milanvidakovic/FPGAComputer/CPU.docx

16-bit CPU

@2018 by Milan Vidaković

# 16-bit CPU

# General information

This 16-bit CPU and computer has been developed using Verilog on the DE0 NANO FPGA board. The code is on the github at the following URL:

https://github.com/milanvidakovic/FPGAComputer

The assembler for this CPU is on the github at the following URL:

https://github.com/milanvidakovic/FPGAcustomasm

The emulator written in Java is on the github at the following URL:

https://github.com/milanvidakovic/FPGAEmulator

The UART loader is on the github at the following URL:

https://github.com/milanvidakovic/FPGARaspbootin64Client

Some photos and background story can be found at:

https://mvidakovic.blogspot.com/2018/06/16-bit-computer-made-using-fpga.html

# Details

This 16-bit CPU has 8 general-purpose registers (r0 – r7), pc (program counter), sp (stack pointer), ir (instruction register), mbr (memory buffer register), h (higher word when multiplying, or remainder when dividing). Each register is 16-bits wide.

The address bus is 16 bits wide, addressing 65536 addresses. Data bus is also 16 bits wide, but all the addresses are 8-bit aligned. This gives 65536 bytes, or 64KB.

By default, address mode is 16-bit. This means that if the instruction does not have the ".b" suffix, it will work with 16-bit operand. Those instructions without ".b" suffix are 16-bit wide. If those instructions deal with memory, the address must be aligned to 16-bits (even).

If the instruction has the ".b" suffix, it is byte-oriented. The address in byte-oriented instructions can be both even and odd.

For example, this instruction is word-oriented:

ld r0, [1000]

It loads the 16-bit content of the address 1000 (two bytes, one byte from the 1001 and the other from 1000) and stores that 16-bit value in the r0 register. The address must be even.

However, this instruction is byte-oriented:

ld.b r0, [1001]

It loads the 8-bit value (one byte) from the address 1001.

It the 16-bit word is stored in the memory, it is stored as big endian, having the lower byte in odd address, and the upper byte in the even address. For example, the number 0x1234 stored at the 1000 address is stored like this:

address | content
1000 | 0x12
1001 | 0x34

Video output signal is VGA, 640x480 pixels. Text mode framebuffer has 80x60 characters, each character being 8x8 pixels in dimensions. Framebuffer in text mode has 4800 16-bit words (80x60 characters with attributes). The lower byte (odd address) has the ASCII character, while the upper byte (even address) has the attributes (3 bits for the ink color, inverted, and 3 bits for the background color, remaining two bits unused).

CPU has three interrupts: IRQ0,IRQ1, and IRQ2. IRQ0 is connected to the KEY2 of the DE0-NANO, while IRQ1 is conencted to the UART. IRQ2 is connected to the PS/2 keyboard connector. Whenever a byte comes to the UART, it generates an IRQ1. Whenever a make or break code comes from the PS/2 keyboard, it generates an IRQ2.

Interrupt causes CPU to push flags to the stack, then to push PC to the stack (the address of the next instruction) and then forces CPU to jump to the location designated for the interrupt:

- for the IRQ0, it is 0x0008,
- for the IRQ1, it is 0x0010, and
- for the IRQ2, it is 0x0018.

It is up to the programmer to put the code in those locations. Usually, it is a JUMP instruction. To return from the interrupt routine, it is necessary to execute the IRET instruction. It pops the return address, and then pops the flags register, and then goes back into the original program.

KEY1 of the DE0-NANO is used as the reset key. When pressed, it forces CPU to go to the 0x0000 address. Usually there is a JUMP instruction to go to the main program.

# VGA text mode

Text mode is 80x60 characters, occupying 4800 words. The framebuffer starts at 26880 decimal. Each character needs two bytes. Lower byte is the ASCII code of a character, while the upper byte is the attributes:

7 | 6 | 5 | 4 | 3 | 2 | 1 | 0
| Foreground color, inverted | | | | Background color
| r | g | b | | r | g | b

The foreground color is inverted so zero values (default) would mean white color. That way, you don't need to set the foreground color to white, and by default (0, 0, 0), is white for the foreground. The default background color is black (0, 0, 0). This means that if the upper (attribute) byte is zero (0x00), the background color is black, and the foreground color is white.

VGA female connector is connected via resistors to the GPIO-0 expansion header of the DE0-NANO board:

- GPIO_R (pin 2, GPIO_00, PIN_A3) -> 68Ohm -> VGA_R,
- GPIO_G (pin 4, GPIO_01, PIN_C3) -> 68Ohm -> VGA_G,
- GPIO_B (pin 6, GPIO_03, PIN_D3) -> 68Ohm -> VGA_B,
- GPIO_HS (pin 8, GPIO_05, PIN_B4) -> 470Ohm -> VGA_HORIZONTAL_SYNC,
- GPIO_VS (pin 10, GPIO_07, PIN_B5) -> 470Ohm -> VGA_VERTICAL_SYNC.

# VGA graphics mode 320x240

This computer also has graphics mode of 320x240 pixels, 8 colors for each pixel. Framebuffer starts at the same address as the text mode one (26880 decimal), but it now displays pixels, instead of characters.

Each pixel can have one of eight colors. There are two pixels per byte in the framebuffer:

7 | 6 | 5 | 4 | 3 | 2 | 1 | 0
| Foreground color, inverted | | | | Background color
| r | g | b | | r | g | b

For example, if you want to draw two red pixels at the (0, 0) coordinates (top left corner), you need to put the following byte into the location 2400:

7 | 6 | 5 | 4 | 3 | 2 | 1 | 0
| Foreground color, inverted | | | | Background color
0 | 1 | 0 | 0 | 0 | 1 | 0 | 0

Or, 0x44 in hex.

Since the default mode is text mode, there is a way to switch video modes:

mov r1, 1

out [128], r1

This code will switch to the graphics mode of 320x240. To switch back to the text mode, you need to execute the following code:

mov r1, 0

out [128], r1

Number 1 at the port 128 sets the video mode to 320x240, while 0 sets to the text mode.

# UART interface

UART interface provides TTL serial communication on 115200kbps. It uses one start bit, one stop bit, and eight data bits, no parity, no handshake.

UART is connected to the GPIO-0 expansion header of the DE0-NANO board:

- TX (pin 32, GPIO_025, PIN_D9) should be connected to the RX pin of the PC,
- RX (pin 34, GPIO_027, PIN_E10) should be connected to the TX pin of the PC.

UART is used within the CPU via IN, and OUT instructions. RX also triggers the IRQ1, which means that whenever a byte is received via UART, the IRQ1 will be triggered, forcing CPU to jump to the 0x0008 address. There you should place the JUMP instruction to your UART interrupt routine.

Inside the UART interrupt routine, you can get the received byte by using the IN instruction:

in r1, [64] ; r1 holds now received byte from the UART (address 64 decimal)

To send a byte, first you need to check if the UART TX is free. You can do it by using the in instruction:

loop:

in r5, [65] ; tx busy in r5

cmp r5, 0

jz not_busy ; if not busy, send back the received character

j loop

not_busy:

out [66], r1 ; send the received character to the UART

Addresses used by the UART are in the following table:

Address | Description
64 | Received byte from the RX part of the UART.
65 | 0 if the TX part of the UART is free to send a byte, 1 if TX part is busy.
66 | Used to put the byte to be sent via TX part of the UART.

# PS/2 keyboard interface

PS/2 connector is connected to the GPIO ports of the DE0-NANO board:

- Data is connected to the GPIO31 (PIN_D11) port
- Clock is connected to the GPIO33 (PIN_B12) port.

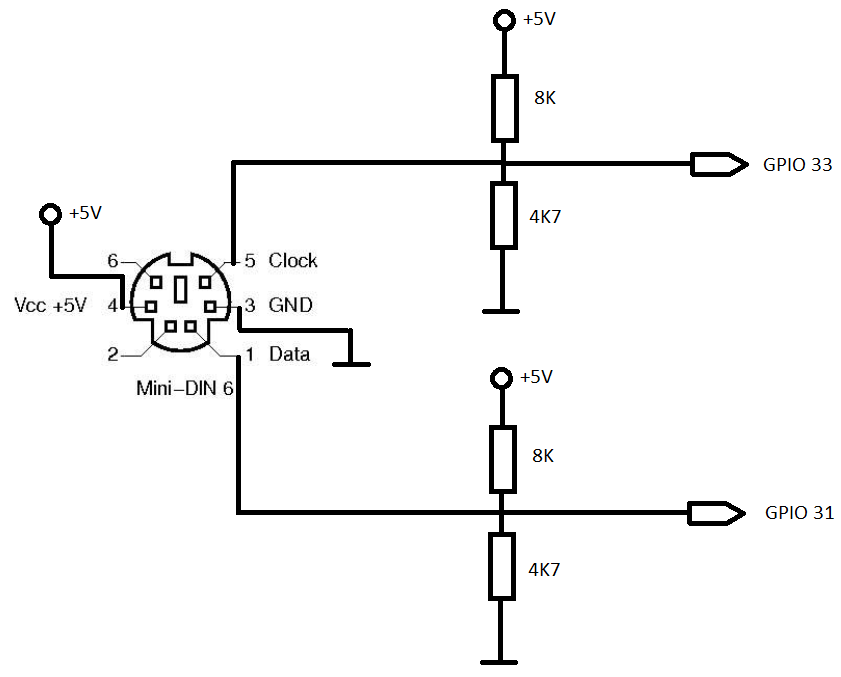
[picture p1: figure]

Connection of the female PS/2 conenctor to the GPIO ports of the DE0 NANO board

The communication between keyboard and computer is a clocked serial. Clock pulses appear on the Clock pin, while data is on the Data pin, synchronized with the Clock on the falling edge. There is one start bit, one parity bit and one stop bit.

The IRQ2 is triggered when a byte from PS/2 keyboard arrives. The CPU then jumps to the address of 24 decimal, where the raw PS/2 keyboard handling routine should be. Actually, at that address should be one JUMP instruction which will jump to the handling routine.

In the interrupt routine, it is necessary to read the raw PS/2 byte that has arrived from the keyboard. To do so, it is necessary to use the IN assembler instruction:

in r0, [68]

Please pay attention that raw PS/2 protocol gives make and break codes when a key is pressed, so this requires quite a lot of processing.

# Instruction set

Group number | Group name | Group members | Group description
0 | NOP/MOV/ IN/OUT/PUSH/ POP/RET/IRET/SWAP/HALT | nop mov reg, xx mov reg, reg in reg, [xx] out [xx], reg push reg push xx pop reg ret iret swap halt | The most general group. Deals with putting values into registers, exchanging values between registers, I/O operations, stack operations, and returning from subroutines. Swapping content between registers is done using th SWAP instruction. NOP and HALT are also in this group.
1 | JUMP | jmp xx jc xx jnc xx jz xx jnz xx jo xx jno xx jp (jge) xx jnp (js) xx jg xx jse xx | Jump to the given location.
2 | CALL | call xx callc xx callnc xx callz xx callnz xx callo xx callno xx callp (callge) xx callnp (calls) xx callg xx callse xx | Calling subroutine. Puts the return address on the stack before jumping to the subroutine. Needs to call RET when returning from the subroutine.
3 | LOAD/STORE | ld reg, [xx] ld reg, [reg] ld reg, [reg + xx] ld.b reg, [reg] ld.b reg, [xx] ld.b reg, [reg + xx] st [xx], reg st [reg], reg st [reg + xx], reg st.b [reg], reg st.b [xx], reg st.b [reg + xx], reg | Load from memory into the register destination: register source: memory address given by the number, or by the register, or by the register+number. Store the given register into the memory location destination: memory location given by the number, or by the register, or by the register+number.
4 | ADD/SUB | add reg, reg add reg, xx add reg, [reg] add reg, [xx] add reg, [reg + xx] add.b reg, [reg] add.b reg, [xx] add.b reg, [reg + xx] sub reg, reg sub reg, xx sub reg, [reg] sub reg, [xx] sub reg, [reg + xx] sub.b reg, [reg] sub.b reg, [xx] sub.b reg, [reg + xx] | ADD and SUB group.
5 | AND/OR | and reg, reg and reg, xx and reg, [reg] and reg, [xx] and reg, [reg + xx] and.b reg, [reg] and.b reg, [xx] and.b reg, [reg + xx] or reg, reg or reg, xx or reg, [reg] or reg, [xx] or reg, [reg + xx] or.b reg, [reg] or.b reg, [xx] or.b reg, [reg + xx] | AND and OR group.
6 | XOR | xor reg, reg xor reg, xx xor reg, [reg] xor reg, [xx] xor reg, [reg + xx] xor.b reg, [reg] xor.b reg, [xx] xor.b reg, [reg + xx] neg reg neg [reg] neg [xx] neg [reg + xx] neg.b [reg] neg.b [xx] neg.b [reg + xx] | XOR and negation (-value).
7 | SHL/SHR | shl reg, reg shl reg, xx shl reg, [reg] shl reg, [xx] shl reg, [reg + xx] shl.b reg, [reg] shl.b reg, [xx] shl.b reg, [reg + xx] shr reg, reg shr reg, xx shr reg, [reg] shr reg, [xx] shr reg, [reg + xx] shr.b reg, [reg] shr.b reg, [xx] shr.b reg, [reg + xx] | Shift left and right.
8 | MUL/DIV | mul reg, reg mul reg, xx mul reg, [reg] mul reg, [xx] mul reg, [reg + xx] mul.b reg, [reg] mul.b reg, [xx] mul.b reg, [reg + xx] div reg, reg div reg, xx div reg, [reg] div reg, [xx] div reg, [reg + xx] div.b reg, [reg] div.b reg, [xx] div.b reg, [reg + xx] | Multiplication and division.
9 | INC/DEC | inc reg inc [reg] inc [xx] inc [reg + xx] inc.b [reg] inc.b [xx] inc.b [reg + xx] dec reg dec [reg] dec [xx] dec [reg + xx] dec.b [reg] dec.b [xx] dec.b [reg + xx] | Increment and decrement.
10 | CMP/INV | cmp reg, reg cmp reg, xx cmp reg, [reg] cmp reg, [xx] cmp reg, [reg + xx] cmp.b reg, [reg] cmp.b reg, [xx] cmp.b reg, [reg + xx] inv reg inv [reg] inv [xx] inv [reg + xx] inv.b [reg] inv.b [xx] inv.b [reg + xx] | Compare registers with registers/memory. Inversion of bits.

# NOP/MOV/IN/OUT/PUSH/POP/RET/IRET/SWAP/HALT GROUP (0x00)

## nop

from | to | what | group
0000 | 0000 | 0000 | 0000

Example:

nop

binary: 0000 0000 0000 0000

hex: 00 00

## mov regx, regy

regx <-- regy

from | to | what | group
bbbb 0-7: r0-r7 8-sp 9-h | bbbb 0-7: r0-r7 8-sp 9-h | 0001 0=>mov regx, regy | 0000

### Example:

mov r2, r1

binary: 0001 0010 0001 0000

hex: 12 00

## mov reg, XX

reg <-- XX

from | to | what | group
xxxx | bbbb 0-7: r0-r7 8-sp | 0010 2 =>mov reg, xx | 0000

### Example:

mov r1, 0x0f

binary: 0000 0001 0010 0000, 0000 0000 0000 1111

hex: 01 20, 00 0f

## in reg, [XX]

from | to | what | group
xxxx | xbbb 0-7: r0-r7 | 0011 3 =>in reg, [xx] | 0000

### Example:

in r1, [0x0f]

binary: 0000 0001 0010 0001, 0000 0000 0000 1111

hex: 01 30, 00 0f

## out [XX], reg

from | to | what | group
xxxx | xbbb 0-7: r0-r7 | 0100 4 =>out [xx], reg | 0000

### Example:

out r1, 0x0f

binary: 0000 0001 0100 0000, 0000 0000 0000 1111

hex: 01 40, 00 0f

## push reg

from | to | what | group
xxxx | bbbb 0-7: r0-r7 8-sp 9-h | 0101 5=>push register | 0000

### Example:

push r0

binary: 0000 0000 0101 0000

hex: 00 50

## push XX

from | to | what | group
xxxx | xxxx | 0110 6=>push number | 0000

### Example:

push 0x0f

binary: 0000 0000 0110 000, 0000 0000 0000 1111

hex: 00 60, 00 0f

## pop reg

from | to | what | group
xxxx | bbbb 0-7: r0-r7 8-sp 9-h | 0111 7=>pop register | 0000

### Example:

pop r0

binary: 0000 0000 0111 0000

hex: 00 70

## ret

Returns from the subroutine.

unused | call/ret kind | group
xxxx xxxx | 1000 8=>return | 0000

### Example:

ret

binary: 0000 0000 1000 0000

hex: 00 80

## iret

Returns from the interrupt subroutine. First it pops flags from the stack, then it pops the return address from the stack.

unused | call/ret kind | group
xxxx xxxx | 10001 9=>return from interrupt | 0000

### Example:

iret

binary: 0000 0000 1001 0000

hex: 00 90

## swap

Swaps two registers content.

from | to | what | group
bbbb 0-7: r0-r7 8-sp 9-h | bbbb 0-7: r0-r7 8-sp 9-h | 1010 10=>swap regx, regy | 0000

### Example:

swap r0, r1

binary: 0000 0001 1010 0000

hex: 00 90

## halt

from | to | what | group
1111 | 1111 | 1111 | 0000

Example:

halt

binary: 1111 1111 1111 0000

hex: ff f0

# JUMP GROUP (0x01)

Jumps (branches).

## jmp xx

Jumps to the given location.

unused | jump kind | group
xxxx xxxx | 0000 jump without condition | 0001

### Example:

j 0xff

binary: 0000 0000 0000 0001, 0000 0000 1111 1111

hex: 00 01, 00 ff

## jz xx

Jumps to the given location, if Zero flag is 1.

unused | jump kind | group
xxxx xxxx | 0001 jump if zero | 0001

### Example:

jz 0001

binary: 0000 0000 0001 0001, 0000 0000 0000 0001

hex: 00 11, 00 01

## jnz xx

Jumps to the given location, if Zero flag is 0.

unused | jump kind | group
xxxx xxxx | 0010 jump if not carry | 0001

### Example:

jnz 0001

binary: 0000 0000 0010 0001, 0000 0000 0000 0001

hex: 00 21, 00 01

## jc xx

Jumps to the given location, if Carry flag is 1.

unused | jump kind | group
xxxx xxxx | 0011 jump if Carry | 0001

### Example:

jc 0001

binary: 0000 0000 0011 0001, 0000 0000 0000 0001

hex: 00 31, 00 01

## jnc xx

Jumps to the given location, if Carry flag is 0.

unused | jump kind | group
xxxx xxxx | 0100 jump if not carry | 0001

### Example:

jnc 0001

binary: 0000 0000 0100 0001, 0000 0000 0000 0001

hex: 00 41, 00 01

## jo xx

Jumps to the given location, if Overflow flag is 1.

unused | jump kind | group
xxxx xxxx | 0101 jump if overflow | 0001

### Example:

jo 0001

binary: 0000 0000 0101 0001, 0000 0000 0000 0001

hex: 00 51, 00 01

## jno xx

Jumps to the given location, if Overflow flag is 0.

unused | jump kind | group
xxxx xxxx | 0110 jump if not overflow | 0001

### Example:

jno 0001

binary: 0000 0000 0110 0001, 0000 0000 0000 0001

hex: 00 61, 00 01

## jp xx (jge xx)

Jumps to the given location, if Positive flag is 1. This is the same as jge xx (jump greater or equal).

unused | jump kind | group
xxxx xxxx | 0111 jump if positive | 0001

### Example:

jp 0001

binary: 0000 0000 0111 0001, 0000 0000 0000 0001

hex: 00 71, 00 01

## jnp xx (js xx)

Jumps to the given location, if Positive flag is 0. The same as js xx (jump if smaller).

unused | jump kind | group
xxxx xxxx | 1000 jump if not positive | 0001

### Example:

jnp 0001

binary: 0000 0000 1000 0001, 0000 0000 0000 0001

hex: 00 81, 00 01

## jg xx

Jumps to the given location, if the last operation produced greater condition (Positive == 1 && Zero == 0).

unused | jump kind | group
xxxx xxxx | 1001 jump if greater | 0001

### Example:

jg 0001

binary: 0000 0000 1001 0001, 0000 0000 0000 0001

hex: 00 91, 00 01

## jse xx

Jumps to the given location, if the last operation produced smaller or equal condition (Positive == 0 && Zero == 1).

unused | jump kind | group
xxxx xxxx | 1010 jump if greater | 0001

### Example:

jse 0001

binary: 0000 0000 1010 0001, 0000 0000 0000 0001

hex: 00 91, 00 01

# CALL GROUP (0x02)

## call xx

Calls the given subroutine.

unused | call/ret kind | group
xxxx xxxx | 0000 call without condition | 0010

### Example:

call 0001

binary: 0000 0000 0000 0010, 0000 0000 0000 0001

hex: 00 02, 00 01

## callz xx

Calls the given location, if Zero flag is 1.

unused | jump kind | group
xxxx xxxx | 0001 call if zero | 0010

### Example:

callz 0001

binary: 0000 0000 0001 0010, 0000 0000 0000 0001

hex: 00 11, 00 01

## callnz xx

Calls the given location, if Zero flag is 0.

unused | jump kind | group
xxxx xxxx | 0010 call if not zero | 0010

### Example:

callnz 0001

binary: 0000 0000 0010 0010, 0000 0000 0000 0001

hex: 00 22, 00 01

## callc xx

Calls the given location, if Carry flag is 1.

unused | jump kind | group
xxxx xxxx | 0011 call if carry | 0010

### Example:

callc 0001

binary: 0000 0000 0011 0010, 0000 0000 0000 0001

hex: 00 32, 00 01

## callnc xx

Calls the given location, if Carry flag is 0.

unused | jump kind | group
xxxx xxxx | 0100 call if not carry | 0010

### Example:

callnc 0001

binary: 0000 0000 0100 0010, 0000 0000 0000 0001

hex: 00 42, 00 01

## callo xx

Calls the given location, if Overflow flag is 1.

unused | jump kind | group
xxxx xxxx | 0101 call if overflow | 0010

### Example:

callo 0001

binary: 0000 0000 0101 0010, 0000 0000 0000 0001

hex: 00 52, 00 01

## callno xx

Calls the given location, if Overflow flag is 0.

unused | jump kind | group
xxxx xxxx | 0110 call if not overflow | 0010

### Example:

callno 0001

binary: 0000 0000 0110 0010, 0000 0000 0000 0001

hex: 00 62, 00 01

## callp xx (callge xx)

Calls the given location, if Positive flag is 1. This is the same as callge xx (call if greater or equal).

unused | jump kind | group
xxxx xxxx | 0001 call if positive | 0010

### Example:

callp 0001

binary: 0000 0000 0111 0010, 0000 0000 0000 0001

hex: 00 72, 00 01

## callnp xx (calls xx)

Calls the given location, if Positive flag is 0. This is the same as calls xx (call if smaller).

unused | jump kind | group
xxxx xxxx | 1000 jump if not positive | 0010

### Example:

callnp 0001

binary: 0000 0000 1000 0010, 0000 0000 0000 0001

hex: 00 82, 00 01

## callg xx

Calls the given location, if the last operation produced greater condition (Positive == 1 && Zero == 0).

unused | jump kind | group
xxxx xxxx | 1001 call if greater | 0010

### Example:

callg 0001

binary: 0000 0000 1001 0010, 0000 0000 0000 0001

hex: 00 92, 00 01

## callse xx

Calls the given location, if the last operation produced smaller or equal condition (Positive == 0 && Zero == 1).

unused | jump kind | group
xxxx xxxx | 1010 call if smaller or equal | 0010

### Example:

callse 0001

binary: 0000 0000 1010 0010, 0000 0000 0000 0001

hex: 00 a2, 00 01

# LOAD/STORE GROUP (0x03)

## ld regx, [regy]

Loads one word (two bytes) from the location to which regy points.

from | to | what | group
bbbb 0-7: r0-r7 8: sp 9: h | bbbb 0-7: r0-r7 8: sp 9: h | 0000 0=>[register] | 0011

### Example:

ld r2, [r1]

binary: 0001 0010 0000 0011

hex: 12 03

## ld reg, [XX]

from | to | what | group
xxx | bbbb 0-7: r0-r7 8: sp 9: h | 0001 1=>[number] | 0011

### Example:

ld r1, [0x0f]

binary: 0000 0001 0001 0011, 0000 0000 0000 1111

hex: 01 13, 00 0f

## ld regx, [regy + XX]

from | to | what | group
bbbb 0-7: r0-r7 8: sp 9: h | bbbb 0-7: r0-r7 8: sp 9: h | 0010 2=>[reg+number] | 0011

### Example:

ld r4, [r3 + 0x0f]

binary: 0011 0100 0010 0011, 0000 0000 0000 1111

hex: 34 23, 00 0f

## ld.b regx, [regy]

Loads one byte from the address to which regy points

from | to | what | group
bbbb 0-7: r0-r7 8: sp 9: h | bbbb 0-7: r0-r7 8: sp 9: h | 0011 3=>[register] | 0011

### Example:

ld.b r2, [r1]

binary: 0001 0010 0011 0011

hex: 12 33

## ld.b reg, [XX]

Loads one byte from the address to which a given number points.

from | to | what | group
xxx | bbbb 0-7: r0-r7 8: sp 9: h | 0100 4=>[number] | 0011

### Example:

ld.b r1, [0x0f]

binary: 0000 0001 0100 0011, 0000 0000 0000 1111

hex: 01 43, 00 0f

## ld.b reg, [reg + XX]

Loads one byte from the address to which a sum of a given register plus given number points.

from | to | what | group
bbbb 0-7: r0-r7 8: sp 9: h | bbbb 0-7: r0-r7 8: sp 9: h | 0101 5=>[reg+number] | 0011

### Example:

ld.b r4, [r3 + 0x0f]

binary: 0011 0100 0101 0011, 0000 0000 0000 1111

hex: 34 53, 00 0f

## st [regy], regx

Stores a regx to the location to which regy points.

from | to | what | group
bbbb 0-7: r0-r7 8: sp 9: h | bbbb 0-7: r0-r7 8: sp 9: h | 1000 8=>register | 0011

### Example:

st [r1], r2

binary: 0010 0001 1001 0011

hex: 21 83

## st [XX], reg

from | to | what | group
bbbb 0-7: r0-r7 8: sp 9: h | xxxx | 1009 9=>number | 0011

### Example:

st [0x0f], r1

binary: 0001 0000 1001 0011, 0000 0000 0000 1111

hex: 10 93, 00 0f

## st [reg + XX], reg

from | to | what | group
bbbb 0-7: r0-r7 8: sp 9: h | bbbb 0-7: r0-r7 8: sp 9: h | 1010 10=>reg+number | 0011

### Example:

st [r3 + 0x0f], r4

binary: 0100 0011 1010 0011, 0000 0000 0000 1111

hex: 43 a3, 00 0f

## st.b [regy], regx

Stores a byte from regx to the location to which regx points.

from | to | what | group
bbbb 0-7: r0-r7 8: sp 9: h | bbbb 0-7: r0-r7 8: sp 9: h | 1011 11=>register | 0011

### Example:

st.b [r1], r2

binary: 0010 0001 1011 0011

hex: 21 b3

## st.b [XX], reg

Stores a byte from reg to the location to which a given number points.

from | to | what | group
bbbb 0-7: r0-r7 8: sp 9: h | xxxx | 1100 12=>number | 0011

### Example:

st.b [0x0f], r1

binary: 0001 0000 1100 0011, 0000 0000 0000 1111

hex: 10 c3, 00 0f

## st.b [regy + XX], regx

Stores a byte from regx to the location to which sum of regx plus a given number points.

from | to | what | group
bbbb 0-7: r0-r7 8: sp 9: h | bbbb 0-7: r0-r7 8: sp 9: h | 1101 13=>reg+number | 0011

### Example:

st.b [r3 + 0x0f], r4

binary: 0100 0011 1101 0011, 0000 0000 0000 1111

hex: 43 d3, 00 0f

# ADD/SUB GROUP (0x0004)

## add regx, regy

regx = regx + regy

from | to | what | group
bbbb 0-7: r0-r7 8: sp 9: h | bbbb 0-7: r0-r7 8: sp 9: h | 0000 0=>regx = regx + regy | 0100

### Example:

add r0, r1

binary: 0001 0000 0000 0100

hex: 10 04

## add reg, xx

regx = regx + xx

from | to | what | group
xxxxx | bbbb 0-7: r0-r7 8: sp 9: h | 0001 1=>regx = regx + xx | 0100

### Example:

add r0, 2

binary: 0000 0000 0001 0100, 0000 0000 0000 0010

hex: 00 14, 00 02

## add regx, [regy]

regx = regx + memory_content(regy)

from | to | what | group
bbbb 0-7: r0-r7 8: sp 9: h | bbbb 0-7: r0-r7 8: sp 9: h | 0010 2=>regx = regx + memory_content(regy) | 0100

### Example:

add r0, [r1]

binary: 0001 0000 0010 0100

hex: 10 24

## add reg, [xx]

regx = regx + memory_content(xx)

from | to | what | group
xxxxx | bbbb 0-7: r0-r7 8: sp 9: h | 0011 3=>regx = regx + memory_content(xx) | 0100

### Example:

add r0, [2]

binary: 0000 0000 0011 0100, 0000 0000 0000 0010

hex: 00 34, 00 02

## add regx, [regy + xx]

regx = regx + memory_content(regy + xx)

from | to | what | group
bbbb 0-7: r0-r7 8: sp 9: h | bbbb 0-7: r0-r7 8: sp 9: h | 0100 4=>regx = regx + memory_content(regy + xx) | 0100

### Example:

add r0, [r1 + 5]

binary: 0001 0000 0100 0100, 0000 0000 0000 0101

hex: 10 44, 00 02

## add.b regx, [regy]

regx = regx + byte_memory_content(regy)

from | to | what | group
bbbb 0-7: r0-r7 8: sp 9: h | bbbb 0-7: r0-r7 8: sp 9: h | 0101 5=>regx = regx + byte_memory_content(regy) | 0100

### Example:

add.b r0, [r1]

binary: 0001 0000 0101 0100

hex: 10 54

## add.b reg, [xx]

regx = regx + byte_memory_content(xx)

from | to | what | group
xxxxx | bbbb 0-7: r0-r7 8: sp 9: h | 0110 6=>regx = regx + byte_memory_content(xx) | 0100

### Example:

add.b r0, [2]

binary: 0000 0000 0110 0100, 0000 0000 0000 0010

hex: 00 64, 00 02

## add.b regx, [regy + xx]

regx = regx + byte_memory_content(regy + xx)

from | to | what | group
bbbb 0-7: r0-r7 8: sp 9: h | bbbb 0-7: r0-r7 8: sp 9: h | 0111 7=>regx = regx + byte_memory_content(regy + xx) | 0100

### Example:

add.b r0, [r1 + 5]

binary: 0001 0000 0100 0100, 0000 0000 0000 0101

hex: 10 74, 00 02

## sub regx, regy

regx = regx - regy

from | to | what | group
bbbb 0-7: r0-r7 8: sp 9: h | bbbb 0-7: r0-r7 8: sp 9: h | 1000 8=>regx = regx - regy | 0100

### Example:

sub r0, r1

binary: 0100 0000 1000 0100

hex: 40 84

## sub reg, xx

regx = regx + xx

from | to | what | group
xxxx | bbbb 0-7: r0-r7 8: sp 9: h | 1001 9=>regx = regx + xx | 0100

### Example:

sub r0, 2

binary: 0000 0000 1001 0100, 0000 0000 0000 0010

hex: 00 94, 00 02

## sub regx, [regy]

regx = regx - memory_content(regy)

from | to | what | group
bbbb 0-7: r0-r7 8: sp 9: h | bbbb 0-7: r0-r7 8: sp 9: h | 1010 10=>regx = regx - memory_content(regy) | 0100

### Example:

sub r0, [r1]

binary: 0001 0000 1010 0100

hex: 10 a4

## sub reg, [xx]

regx = regx - memory_content(xx)

from | to | what | group
xxxxx | bbbb 0-7: r0-r7 8: sp 9: h | 1011 11=>regx = regx - memory_content(xx) | 0100

### Example:

sub r0, [2]

binary: 0000 0000 1011 0100, 0000 0000 0000 0010

hex: 00 b4, 00 02

## sub regx, [regy + xx]

regx = regx - memory_content(regy + xx)

from | to | what | group
bbbb 0-7: r0-r7 8: sp 9: h | bbbb 0-7: r0-r7 8: sp 9: h | 1100 12=>regx = regx - memory_content(regy + xx) | 0100

### Example:

sub r0, [r1 + 5]

binary: 0001 0000 1100 0100, 0000 0000 0000 0101

hex: 10 c4, 00 05

## sub.b regx, [regy]

regx = regx - byte_memory_content(regy)

from | to | what | group
bbbb 0-7: r0-r7 8: sp 9: h | bbbb 0-7: r0-r7 8: sp 9: h | 1101 13=>regx = regx – byte_memory_content(regy) | 0100

### Example:

sub.b r0, [r1]

binary: 0001 0000 1101 0100

hex: 10 d4

## sub.b reg, [xx]

regx = regx - byte_memory_content(xx)

from | to | what | group
xxxxx | bbbb 0-7: r0-r7 8: sp 9: h | 1110 14=>regx = byte_regx - memory_content(xx) | 0100

### Example:

sub.b r0, [2]

binary: 0000 0000 1110 0100, 0000 0000 0000 0010

hex: 00 e4, 00 02

## sub.b regx, [regy + xx]

regx = regx - byte_memory_content(regy + xx)

from | to | what | group
bbbb 0-7: r0-r7 8: sp 9: h | bbbb 0-7: r0-r7 8: sp 9: h | 1111 15=>regx = regx - byte_memory_content(regy + xx) | 0100

### Example:

sub.b r0, [r1 + 5]

binary: 0001 0000 1111 0100, 0000 0000 0000 0101

hex: 10 f4, 00 05

# AND/OR GROUP (0x0005)

## and regx, regy

regx = regx AND regy

from | to | what | group
bbbb 0-7: r0-r7 8: sp 9: h | bbbb 0-7: r0-r7 8: sp 9: h | 0000 0=>regx = regx AND regy | 0101

### Example:

and r0, r1

binary: 0100 0000 0000 0101

hex: 40 05

## and reg, xx

regx = regx AND xx

from | to | what | group
xxxx | bbbb 0-7: r0-r7 8: sp 9: h | 0001 1=>regx = regx AND xx | 0101

### Example:

and r0, 2

binary: 0000 0000 0001 0101, 0000 0000 0000 0010

hex: 00 15, 00 02

## and regx, [regy]

regx = regx AND memory_content(regy)

from | to | what | group
bbbb 0-7: r0-r7 8: sp 9: h | bbbb 0-7: r0-r7 8: sp 9: h | 0010 2=>regx = regx AND memory_content(regy) | 0101

### Example:

and r0, [r1]

binary: 0001 0000 0010 0101

hex: 10 25

## and reg, [xx]

regx = regx AND memory_content(xx)

from | to | what | group
xxxxx | bbbb 0-7: r0-r7 8: sp 9: h | 0011 3=>regx = regx AND memory_content(xx) | 0101

### Example:

and r0, [2]

binary: 0000 0000 0011 0101, 0000 0000 0000 0010

hex: 00 35, 00 02

## and regx, [regy + xx]

regx = regx AND memory_content(regy + xx)

from | to | what | group
bbbb 0-7: r0-r7 8: sp 9: h | bbbb 0-7: r0-r7 8: sp 9: h | 0100 4=>regx = regx AND memory_content(regy + xx) | 0101

### Example:

and r0, [r1 + 5]

binary: 0001 0000 0100 0101, 0000 0000 0000 0101

hex: 10 45, 00 02

## and regx, [regy]

regx = regx AND memory_content(regy)

from | to | what | group
bbbb 0-7: r0-r7 8: sp 9: h | bbbb 0-7: r0-r7 8: sp 9: h | 0101 b=>regx = regx AND byte_memory_content(regy) | 0101

### Example:

and.b r0, [r1]

binary: 0001 0000 0101 0101

hex: 10 55

## and.b reg, [xx]

regx = regx AND byte_memory_content(xx)

from | to | what | group
xxxxx | bbbb 0-7: r0-r7 8: sp 9: h | 0110 6=>regx = regx AND byte_memory_content(xx) | 0101

### Example:

and.b r0, [2]

binary: 0000 0000 0110 0101, 0000 0000 0000 0010

hex: 00 65, 00 02

## and.b regx, [regy + xx]

regx = regx AND byte_memory_content(regy + xx)

from | to | what | group
bbbb 0-7: r0-r7 8: sp 9: h | bbbb 0-7: r0-r7 8: sp 9: h | 0111 7=>regx = regx AND byte_memory_content(regy + xx) | 0101

### Example:

and.b r0, [r1 + 5]

binary: 0001 0000 0111 0101, 0000 0000 0000 0101

hex: 10 75, 00 02

## or regx, regy

regx = regx OR regy

from | to | what | group
bbbb 0-7: r0-r7 8: sp 9: h | bbbb 0-7: r0-r7 8: sp 9: h | 1000 8=>regx = regx OR regy | 0101

### Example:

or r0, r1

binary: 0100 0000 1000 0101

hex: 40 85

## or reg, xx

regx = regx OR xx

from | to | what | group
xxxx | bbbb 0-7: r0-r7 8: sp 9: h | 1001 9=>regx = regx OR xx | 0101

### Example:

or r0, 2

binary: 0000 0000 1001 0101, 0000 0000 0000 0010

hex: 00 95, 00 02

## or regx, [regy]

regx = regx OR memory_content(regy)

from | to | what | group
bbbb 0-7: r0-r7 8: sp 9: h | bbbb 0-7: r0-r7 8: sp 9: h | 1010 10=>regx = regx OR memory_content(regy) | 0101

### Example:

or r0, [r1]

binary: 0001 0000 1010 0101

hex: 10 a5

## or reg, [xx]

regx = regx OR memory_content(xx)

from | to | what | group
xxxxx | bbbb 0-7: r0-r7 8: sp 9: h | 1011 11=>regx = regx OR memory_content(xx) | 0101

### Example:

or r0, [2]

binary: 0000 0000 1011 0101, 0000 0000 0000 0010

hex: 00 b5, 00 02

## or regx, [regy + xx]

regx = regx OR memory_content(regy + xx)

from | to | what | group
bbbb 0-7: r0-r7 8: sp 9: h | bbbb 0-7: r0-r7 8: sp 9: h | 1100 12=>regx = regx OR memory_content(regy + xx) | 0101

### Example:

or r0, [r1 + 5]

binary: 0001 0000 1100 0101, 0000 0000 0000 0101

hex: 10 c5, 00 05

## or.b regx, [regy]

regx = regx OR byte_memory_content(regy)

from | to | what | group
bbbb 0-7: r0-r7 8: sp 9: h | bbbb 0-7: r0-r7 8: sp 9: h | 1101 13=>regx = regx OR byte_memory_content(regy) | 0101

### Example:

or.b r0, [r1]

binary: 0001 0000 1101 0101

hex: 10 d5

## or.b reg, [xx]

regx = regx OR byte_memory_content(xx)

from | to | what | group
xxxxx | bbbb 0-7: r0-r7 8: sp 9: h | 1110 14=>regx = regx OR byte_memory_content(xx) | 0101

### Example:

or.b r0, [2]

binary: 0000 0000 1110 0101, 0000 0000 0000 0010

hex: 00 e5, 00 02

## or.b regx, [regy + xx]

regx = regx OR byte_memory_content(regy + xx)

from | to | what | group
bbbb 0-7: r0-r7 8: sp 9: h | bbbb 0-7: r0-r7 8: sp 9: h | 11111 15=>regx = regx OR byte_memory_content(regy + xx) | 0101

### Example:

or.b r0, [r1 + 5]

binary: 0001 0000 1111 0101, 0000 0000 0000 0101

hex: 10 f5, 00 05

# XOR/NEG GROUP (0x0006)

## xor regx, regy

regx = regx XOR regy

from | to | what | group
bbbb 0-7: r0-r7 8: sp 9: h | bbbb 0-7: r0-r7 8: sp 9: h | 0000 0=>regx = regx XOR regy | 0110

### Example:

xor r0, r1

binary: 0100 0000 0000 0110

hex: 40 06

## xor reg, xx

regx = regx XOR xx

from | to | what | group
xxxx | bbbb 0-7: r0-r7 8: sp 9: h | 1011 11=>regx = regx XOR xx | 0110

### Example:

xor r0, 2

binary: 0000 0000 0001 0110, 0000 0000 0000 0010

hex: 00 16, 00 02

## xor regx, [regy]

regx = regx XOR memory_content(regy)

from | to | what | group
bbbb 0-7: r0-r7 8: sp 9: h | bbbb 0-7: r0-r7 8: sp 9: h | 0010 2=>regx = regx XOR memory_content(regy) | 0110

### Example:

xor r0, [r1]

binary: 0001 0000 0010 0110

hex: 10 26

## xor reg, [xx]

regx = regx XOR memory_content(xx)

from | to | what | group
xxxxx | bbbb 0-7: r0-r7 8: sp 9: h | 0011 3=>regx = regx XOR memory_content(xx) | 0110

### Example:

xor r0, [2]

binary: 0000 0000 0011 0110, 0000 0000 0000 0010

hex: 00 36, 00 02

## xor regx, [regy + xx]

regx = regx XOR memory_content(regy + xx)

from | to | what | group
bbbb 0-7: r0-r7 8: sp 9: h | bbbb 0-7: r0-r7 8: sp 9: h | 0100 4=>regx = regx XOR memory_content(regy + xx) | 0110

### Example:

xor r0, [r1 + 5]

binary: 0001 0000 0100 0110, 0000 0000 0000 0101

hex: 10 46, 00 05

## xor.b regx, [regy]

regx = regx XOR memory_content(regy)

from | to | what | group
bbbb 0-7: r0-r7 8: sp 9: h | bbbb 0-7: r0-r7 8: sp 9: h | 0101 5=>regx = regx XOR byte_memory_content(regy) | 0110

### Example:

xor.b r0, [r1]

binary: 0001 0000 0101 0110

hex: 10 56

## xor.b reg, [xx]

regx = regx XOR byte_memory_content(xx)

from | to | what | group
xxxxx | bbbb 0-7: r0-r7 8: sp 9: h | 0110 6=>regx = regx XOR byte_memory_content(xx) | 0110

### Example:

xor.b r0, [2]

binary: 0000 0000 0110 0110, 0000 0000 0000 0010

hex: 00 66, 00 02

## xor.b regx, [regy + xx]

regx = regx XOR byte_memory_content(regy + xx)

from | to | what | group
bbbb 0-7: r0-r7 8: sp 9: h | bbbb 0-7: r0-r7 8: sp 9: h | 0111 7=>regx = regx XOR byte_memory_content(regy + xx) | 0110

### Example:

xor.b r0, [r1 + 5]

binary: 0001 0000 0111 0110, 0000 0000 0000 0101

hex: 10 76, 00 05

## neg reg

Negates the given register.

from | to | what | group
bbbb 0-7: r0-r7 8: sp 9: h | xxxx | 1000 8=>neg reg | 0110

### Example:

neg r0

binary: 0000 0000 1000 0110

hex: 00 86

## neg [reg]

Negates the memory_content(reg).

from | to | what | group
bbbb 0-7: r0-r7 8: sp 9: h | xxxx | 1010 10=> neg memory_content(reg) | 0110

### Example:

neg [r1]

binary: 0001 0000 1010 0110

hex: 01 a6

## neg [xx]

Negates the memory_content(xx).

from | to | what | group
xxxxx | xxxx | 1011 11=> neg memory_content(xx) | 0110

### Example:

neg [2]

binary: 0000 0000 1011 1010, 0000 0000 0000 0010

hex: 00 b6, 00 02

## neg [reg + xx]

Negates the memory_content(reg + xx).

from | to | what | group
bbbb 0-7: r0-r7 8: sp 9: h | xxxx | 1100 12=> neg memory_content(reg + xx) | 0110

### Example:

neg [r1 + 5]

binary: 0001 0000 1100 0110, 0000 0000 0000 0101

hex: 10 c6, 00 05

## neg.b [reg]

Negates the byte_memory_content(reg).

from | to | what | group
bbbb 0-7: r0-r7 8: sp 9: h | xxxx | 1101 13=> neg byte_memory_content(reg) | 0110

### Example:

neg.b [r1]

binary: 0001 0000 1101 0110

hex: 10 d6

## neg.b [xx]

Negates the byte_memory_content(xx).

from | to | what | group
xxxxx | xxxx | 1110 14=> neg byte_memory_content(xx) | 0110

### Example:

neg.b [2]

binary: 0000 0000 1110 0110, 0000 0000 0000 0010

hex: 00 e6, 00 02

## neg.b [reg + xx]

Negates the byte_memory_content(reg + xx).

from | to | what | group
bbbb 0-7: r0-r7 8: sp 9: h | xxxx | 1111 15=> neg byte_memory_content(reg + xx) | 0110

### Example:

neg.b [r1 + 5]

binary: 0001 0000 1111 0110, 0000 0000 0000 0101

hex: 10 f6, 00 05

# SHIFT GROUP (0x0007)

## shl regx, regy

regx = regx << regy

from | to | what | group
bbbb 0-7: r0-r7 8: sp 9: h | bbbb 0-7: r0-r7 8: sp 9: h | 0000 0=>regx = regx << regy | 0111

### Example:

shl r0, r1

binary: 0100 0000 0000 0111

hex: 40 07

## shl reg, xx

regx = regx << xx

from | to | what | group
xxxx | bbbb 0-7: r0-r7 8: sp 9: h | 0001 1=>regx = regx << xx | 0111

### Example:

shl r0, 2

binary: 0000 0000 0001 0111, 0000 0000 0000 0010

hex: 00 17, 00 02

## shl regx, [regy]

regx = regx << memory_content(regy)

from | to | what | group
bbbb 0-7: r0-r7 8: sp 9: h | bbbb 0-7: r0-r7 8: sp 9: h | 0010 2=>regx = regx << memory_content(regy) | 0111

### Example:

shl r0, [r1]

binary: 0001 0000 0010 0111

hex: 10 27

## shl reg, [xx]

regx = regx << memory_content(xx)

from | to | what | group
xxxxx | bbbb 0-7: r0-r7 8: sp 9: h | 0011 3=>regx = regx << memory_content(xx) | 0111

### Example:

shl r0, [2]

binary: 0000 0000 0011 0111, 0000 0000 0000 0010

hex: 00 37, 00 02

## shl regx, [regy + xx]

regx = regx << memory_content(regy + xx)

from | to | what | group
bbbb 0-7: r0-r7 8: sp 9: h | bbbb 0-7: r0-r7 8: sp 9: h | 0100 4=>regx = regx << memory_content(regy + xx) | 0111

### Example:

shl r0, [r1 + 5]

binary: 0001 0000 0100 0111, 0000 0000 0000 0101

hex: 10 47, 00 05

## shl.b regx, [regy]

regx = regx << byte_memory_content(regy)

from | to | what | group
bbbb 0-7: r0-r7 8: sp 9: h | bbbb 0-7: r0-r7 8: sp 9: h | 0101 5=>regx = regx << byte_memory_content(regy) | 0111

### Example:

shl.b r0, [r1]

binary: 0001 0000 0101 0111

hex: 10 57

## shl.b reg, [xx]

regx = regx << byte_memory_content(xx)

from | to | what | group
xxxxx | bbbb 0-7: r0-r7 8: sp 9: h | 0110 6=>regx = regx << byte_memory_content(xx) | 0111

### Example:

shl.b r0, [2]

binary: 0000 0000 0110 0111, 0000 0000 0000 0010

hex: 00 67, 00 02

## shl.b regx, [regy + xx]

regx = regx << byte_memory_content(regy + xx)

from | to | what | group
bbbb 0-7: r0-r7 8: sp 9: h | bbbb 0-7: r0-r7 8: sp 9: h | 0111 7=>regx = regx << byte_memory_content(regy + xx) | 0111

### Example:

shl.b r0, [r1 + 5]

binary: 0001 0000 0111 0111, 0000 0000 0000 0101

hex: 10 77, 00 05

## shr regx, regy

regx = regx >> regy

from | to | what | group
bbbb 0-7: r0-r7 8: sp 9: h | bbbb 0-7: r0-r7 8: sp 9: h | 1000 8=>regx = regx >> regy | 0111

### Example:

shr r0, r1

binary: 0100 0000 0110 0111

hex: 40 87

## shr reg, xx

regx = regx + xx

from | to | what | group
xxxx | bbbb 0-7: r0-r7 8: sp 9: h | 1001 9=>regx = regx >> xx | 0111

### Example:

shr r0, 2

binary: 0000 0000 1001 0111, 0000 0000 0000 0010

hex: 00 97, 00 02

## shr regx, [regy]

regx = regx >> memory_content(regy)

from | to | what | group
bbbb 0-7: r0-r7 8: sp 9: h | bbbb 0-7: r0-r7 8: sp 9: h | 1010 10=>regx = regx >> memory_content(regy) | 0111

### Example:

shr r0, [r1]

binary: 0001 0000 1010 0111

hex: 10 a7

## shr reg, [xx]

regx = regx << memory_content(xx)

from | to | what | group
xxxxx | bbbb 0-7: r0-r7 8: sp 9: h | 1011 11=>regx = regx >> memory_content(xx) | 0111

### Example:

shr r0, [2]

binary: 0000 0000 1011 0111, 0000 0000 0000 0010

hex: 00 b7, 00 02

## shr regx, [regy + xx]

regx = regx >> memory_content(regy + xx)

from | to | what | group
bbbb 0-7: r0-r7 8: sp 9: h | bbbb 0-7: r0-r7 8: sp 9: h | 1100 12=>regx = regx >> memory_content(regy + xx) | 0111

### Example:

shr r0, [r1 + 5]

binary: 0001 0000 1100 0111, 0000 0000 0000 0101

hex: 10 c7, 00 05

## shr.b regx, [regy]

regx = regx >> byte_memory_content(regy)

from | to | what | group
bbbb 0-7: r0-r7 8: sp 9: h | bbbb 0-7: r0-r7 8: sp 9: h | 1101 13=>regx = regx >> byte_memory_content(regy) | 0111

### Example:

shr.b r0, [r1]

binary: 0001 0000 1101 0111

hex: 10 d7

## shr.b reg, [xx]

regx = regx << byte_memory_content(xx)

from | to | what | group
xxxxx | bbbb 0-7: r0-r7 8: sp 9: h | 1110 14=>regx = regx >> byte_memory_content(xx) | 0111

### Example:

shr.b r0, [2]

binary: 0000 0000 1110 0111, 0000 0000 0000 0010

hex: 00 e7, 00 02

## shr.b regx, [regy + xx]

regx = regx >> byte_memory_content(regy + xx)

from | to | what | group
bbbb 0-7: r0-r7 8: sp 9: h | bbbb 0-7: r0-r7 8: sp 9: h | 1111 15=>regx = regx >> byte_memory_content(regy + xx) | 0111

### Example:

shr.b r0, [r1 + 5]

binary: 0001 0000 1111 0111, 0000 0000 0000 0101

hex: 10 f7, 00 05

# MUL/DIV GROUP (0x0008)

## mul regx, regy

regx = regx * regy

from | to | what | group
bbbb 0-7: r0-r7 8: sp 9: h | bbbb 0-7: r0-r7 8: sp 9: h | 0000 0=>regx = lower_16_bits(regx * regy) h = upper_16_bits(regx * regy) | 1000

### Example:

mul r0, r1

binary: 0001 0000 0000 1000

hex: 10 08

## mul reg, XX

reg = reg * XX

from | to | what | group
xxxx | bbbb 0-7: r0-r7 8: sp 9: h | 0001 1 =>reg = lower_16_bits(reg * number) h = upper_16_bits(reg * number) | 1010

### Example:

mul r1, 5

binary: 0000 0001 0001 1000, 0000 0000 0000 0101

hex: 01 18, 00 05

## mul regx, [regy]

regx = regx * memory_content(regy)

from | to | what | group
bbbb 0-7: r0-r7 8: sp 9: h | bbbb 0-7: r0-r7 8: sp 9: h | 0010 2=>regx = regx * memory_content(regy) h = upper_16_bits(reg * number) | 1000

### Example:

mul r0, [r1]

binary: 0001 0000 0010 1000

hex: 10 28

## mul reg, [xx]

regx = regx * memory_content(xx)

from | to | what | group
xxxxx | bbbb 0-7: r0-r7 8: sp 9: h | 0011 3=>regx = regx * memory_content(xx) h = upper_16_bits(reg * number) | 1000

### Example:

mul r0, [2]

binary: 0000 0000 0011 1000, 0000 0000 0000 0010

hex: 00 38, 00 02

## mul regx, [regy + xx]

regx = regx * memory_content(regy + xx)

from | to | what | group
bbbb 0-7: r0-r7 8: sp 9: h | bbbb 0-7: r0-r7 8: sp 9: h | 0100 4=>regx = regx * memory_content(regy + xx) h = upper_16_bits(reg * number) | 1000

### Example:

mul r0, [r1 + 5]

binary: 0001 0000 0100 1000, 0000 0000 0000 0101

hex: 10 48, 00 05

## mul.b regx, [regy]

regx = regx * byte_memory_content(regy)

from | to | what | group
bbbb 0-7: r0-r7 8: sp 9: h | bbbb 0-7: r0-r7 8: sp 9: h | 0101 5=>regx = regx * byte_memory_content(regy) h = upper_16_bits(reg * number) | 1000

### Example:

mul.b r0, [r1]

binary: 0001 0000 0101 1000

hex: 10 58

## mul.b reg, [xx]

regx = regx * byte_memory_content(xx)

from | to | what | group
xxxxx | bbbb 0-7: r0-r7 8: sp 9: h | 0110 6=>regx = regx * byte_memory_content(xx) h = upper_16_bits(reg * number) | 1000

### Example:

mul.b r0, [2]

binary: 0000 0000 0110 1000, 0000 0000 0000 0010

hex: 00 68, 00 02

## mul.b regx, [regy + xx]

regx = regx * byte_memory_content(regy + xx)

from | to | what | group
bbbb 0-7: r0-r7 8: sp 9: h | bbbb 0-7: r0-r7 8: sp 9: h | 0111 7=>regx = regx * byte_memory_content(regy + xx) h = upper_16_bits(reg * number) | 1000

### Example:

mul.b r0, [r1 + 5]

binary: 0001 0000 0111 1000, 0000 0000 0000 0101

hex: 10 78, 00 05

## div regx, regy

regx = regx / regy

from | to | what | group
bbbb 0-7: r0-r7 8: sp 9: h | bbbb 0-7: r0-r7 8: sp 9: h | 1000 8=>regx = regx / regy h = regx % regy | 1000

### Example:

div r0, r1

binary: 0001 0000 1000 1000

hex: 10 88

## div reg, XX

reg = reg / XX

from | to | what | group
xxxx | bbbb 0-7: r0-r7 8: sp 9: h | 1001 9 =>reg = reg / number h = reg % number | 1000

### Example:

div r1, 5

binary: 0000 0001 1001 1000, 0000 0000 0000 0101

hex: 01 98, 00 05

## div regx, [regy]

regx = regx / memory_content(regy)

from | to | what | group
bbbb 0-7: r0-r7 8: sp 9: h | bbbb 0-7: r0-r7 8: sp 9: h | 1010 10=>regx = regx / memory_content(regy) h = regx % regy | 1000

### Example:

div r0, [r1]

binary: 0001 0000 1010 1000

hex: 10 a8

## div reg, [xx]

regx = regx / memory_content(xx)

from | to | what | group
xxxxx | bbbb 0-7: r0-r7 8: sp 9: h | 1011 11=>regx = regx / memory_content(xx) h = regx % regy | 1000

### Example:

div r0, [2]

binary: 0000 0000 1011 1000, 0000 0000 0000 0010

hex: 00 b8, 00 02

## div regx, [regy + xx]

regx = regx / memory_content(regy + xx)

from | to | what | group
bbbb 0-7: r0-r7 8: sp 9: h | bbbb 0-7: r0-r7 8: sp 9: h | 1100 12=>regx = regx / memory_content(regy + xx) h = regx % regy | 1000

### Example:

div r0, [r1 + 5]

binary: 0001 0000 1100 1000, 0000 0000 0000 0101

hex: 10 c8, 00 05

## div.b regx, [regy]

regx = regx / byte_memory_content(regy)

from | to | what | group
bbbb 0-7: r0-r7 8: sp 9: h | bbbb 0-7: r0-r7 8: sp 9: h | 1010 10=>regx = regx / byte_memory_content(regy) h = regx % regy | 1000

### Example:

div.b r0, [r1]

binary: 0001 0000 1101 1000

hex: 10 d8

## div reg, [xx]

regx = regx / byte_memory_content(xx)

from | to | what | group
xxxxx | bbbb 0-7: r0-r7 8: sp 9: h | 1110 14=>regx = regx / byte_memory_content(xx) h = regx % regy | 1000

### Example:

div.b r0, [2]

binary: 0000 0000 1110 1000, 0000 0000 0000 0010

hex: 00 e8, 00 02

## div.b regx, [regy + xx]

regx = regx / byte_memory_content(regy + xx)

from | to | what | group
bbbb 0-7: r0-r7 8: sp 9: h | bbbb 0-7: r0-r7 8: sp 9: h | 1111 15=>regx = regx / byte_memory_content(regy + xx) h = regx % regy | 1000

### Example:

div.b r0, [r1 + 5]

binary: 0001 0000 1111 1000, 0000 0000 0000 0101

hex: 10 f8, 00 05

# INC/DEC GROUP (0x0009)

## inc reg

Increments the given register.

from | to | what | group
xxxx | bbbb 0-7: r0-r7 8: sp 9: h | 0000 0=>inc reg | 1001

### Example:

inc r0

binary: 0000 0000 0000 1001

hex: 00 09

## inc [reg]

Increments the memory_content(reg).

from | to | what | group
xxxx | bbbb 0-7: r0-r7 8: sp 9: h | 0001 1=> inc memory_content(reg) | 1001

### Example:

inc [r1]

binary: 0000 0001 0001 1001

hex: 01 19

## inc [xx]

Increments the memory_content(xx).

from | to | what | group
xxxxx | xxxx | 0010 2=> inc memory_content(xx) | 1001

### Example:

inc [2]

binary: 0000 0000 0010 1001, 0000 0000 0000 0010

hex: 00 29, 00 02

## inc [reg + xx]

Increments the memory_content(reg + xx).

from | to | what | group
xxxx | bbbb 0-7: r0-r7 8: sp 9: h | 0011 3=> inc memory_content(reg + xx) | 1001

### Example:

inc [r1 + 5]

binary: 0000 0001 0011 1001, 0000 0000 0000 0101

hex: 01 39, 00 05

## inc.b [reg]

Increments the byte_memory_content(reg).

from | to | what | group
xxxx | bbbb 0-7: r0-r7 8: sp 9: h | 0100 4=> inc byte_memory_content(reg) | 1001

### Example:

inc.b [r1]

binary: 0000 0001 0100 1001

hex: 01 49

## inc.b [xx]

Increments the byte_memory_content(xx).

from | to | what | group
xxxxx | xxxx | 0101 5=> inc byte_memory_content(xx) | 1001

### Example:

inc.b [2]

binary: 0000 0000 0101 1001, 0000 0000 0000 0010

hex: 00 59, 00 02

## inc [reg + xx]

Increments the memory_content(reg + xx).

from | to | what | group
xxxx | bbbb 0-7: r0-r7 8: sp 9: h | 0110 6=> inc byte_memory_content(reg + xx) | 1001

### Example:

inc.b [r1 + 5]

binary: 0000 0001 0110 1001, 0000 0000 0000 0101

hex: 01 69, 00 05

## dec reg

Decrements the given register.

from | to | what | group
xxxx | bbbb 0-7: r0-r7 8: sp 9: h | 1000 8=>dec reg | 1001

### Example:

dec r0

binary: 0000 0000 1000 1001

hex: 00 89

## dec [reg]

Decrements the memory_content(reg).

from | to | what | group
xxxx | bbbb 0-7: r0-r7 8: sp 9: h | 1001 9=> dec memory_content(reg) | 1001

### Example:

dec [r1]

binary: 0000 0001 1001 1001

hex: 01 99

## dec [xx]

Decrements the memory_content(xx).

from | to | what | group
xxxxx | xxxx | 1010 10=> dec memory_content(xx) | 1001

### Example:

dec [2]

binary: 0000 0000 1010 1001, 0000 0000 0000 0010

hex: 00 a9, 00 02

## dec [reg + xx]

Decrements the memory_content(reg + xx).

from | to | what | group
xxxx | bbbb 0-7: r0-r7 8: sp 9: h | 1011 11=> dec memory_content(reg + xx) | 1001

### Example:

dec [r1 + 5]

binary: 0000 0001 1011 1001, 0000 0000 0000 0101

hex: 01 b9, 00 05

## dec.b [reg]

Decrements the byte_memory_content(reg).

from | to | what | group
xxxx | bbbb 0-7: r0-r7 8: sp 9: h | 1100 12=> dec byte_memory_content(reg) | 1001

### Example:

dec.b [r1]

binary: 0000 0001 1100 1001

hex: 01 c9

## dec.b [xx]

Decrements the byte_memory_content(xx).

from | to | what | group
xxxxx | xxxx | 1101 13=> dec byte_memory_content(xx) | 1001

### Example:

dec.b [2]

binary: 0000 0000 1101 1001, 0000 0000 0000 0010

hex: 00 d9, 00 02

## dec.b [reg + xx]

Decrements the byte_memory_content(reg + xx).

from | to | what | group
xxxx | bbbb 0-7: r0-r7 8: sp 9: h | 1110 14=> dec byte_memory_content(reg + xx) | 1001

### Example:

dec.b [r1 + 5]

binary: 0000 0001 1110 1001, 0000 0000 0000 0101

hex: 01 e9, 00 05

# CMP/INV GROUP (0x000a)

## cmp regx, regy

Compares regx and regy, by subtracting them and not storing the result; just setting the flags.

from | to | what | group
bbbb 0-7: r0-r7 8: sp 9: h | bbbb 0-7: r0-r7 8: sp 9: h | 0000 0=>cmp regx, regy | 1010

### Example:

cmp r0, r1

binary: 0001 0000 0000 1010

hex: 10 0a

## cmp reg, xx

Compares reg and number xx, by subtracting them and not storing the result; just setting the flags.

from | to | what | group
xxxx | bbbb 0-7: r0-r7 8: sp 9: h | 0001 1=>cmp reg, xx | 1010

### Example:

cmp r0, 2

binary: 0000 0000 0001 1010, 0000 0000 0000 0010

hex: 00 1a, 00 02

## cmp regx, [regy]

Compare regx and memory_content(regy).

from | to | what | group
bbbb 0-7: r0-r7 8: sp 9: h | bbbb 0-7: r0-r7 8: sp 9: h | 0010 2=> compare regx and memory_content(regy) | 1010

### Example:

cmp r0, [r1]

binary: 0001 0000 0010 1010

hex: 10 2a

## cmp reg, [xx]

Compare regx and memory_content(xx).

from | to | what | group
xxxxx | bbbb 0-7: r0-r7 8: sp 9: h | 0011 3=> compare regx and memory_content(xx) | 1010

### Example:

cmp r0, [2]

binary: 0000 0000 0011 1010, 0000 0000 0000 0010

hex: 00 3a, 00 02

## cmp regx, [regy + xx]

Compare regx and memory_content(regy + xx).

from | to | what | group
bbbb 0-7: r0-r7 8: sp 9: h | bbbb 0-7: r0-r7 8: sp 9: h | 0100 4=> Compare regx and memory_content(regy + xx) | 1010

### Example:

cmp r0, [r1 + 5]

binary: 0001 0000 0100 1010, 0000 0000 0000 0101

hex: 10 4a, 00 05

## cmp.b regx, [regy]

Compare regx and byte_memory_content(regy).

from | to | what | group
bbbb 0-7: r0-r7 8: sp 9: h | bbbb 0-7: r0-r7 8: sp 9: h | 0101 5=> compare regx and byte_memory_content(regy) | 1010

### Example:

cmp.b r0, [r1]

binary: 0001 0000 0101 1010

hex: 10 5a

## cmp.b reg, [xx]

Compare regx and byte_memory_content(xx).

from | to | what | group
xxxxx | bbbb 0-7: r0-r7 8: sp 9: h | 0110 6=> compare regx and byte_memory_content(xx) | 1010

### Example:

cmp.b r0, [2]

binary: 0000 0000 0110 1010, 0000 0000 0000 0010

hex: 00 6a, 00 02

## cmp.b regx, [regy + xx]

Compare regx and byte_memory_content(regy + xx).

from | to | what | group
bbbb 0-7: r0-r7 8: sp 9: h | bbbb 0-7: r0-r7 8: sp 9: h | 0111 7=> Compare regx and byte_memory_content(regy + xx) | 1010

### Example:

cmp.b r0, [r1 + 5]

binary: 0001 0000 0111 1010, 0000 0000 0000 0101

hex: 10 7a, 00 05

## inv reg

Inverts the given register.

from | to | what | group
xxxx | bbbb 0-7: r0-r7 8: sp 9: h | 1000 8=>neg reg | 1010

### Example:

neg r0

binary: 0000 0000 1000 1010

hex: 00 8a

## inv [reg]

Negates the memory_content(reg).

from | to | what | group
xxxx | bbbb 0-7: r0-r7 8: sp 9: h | 1001 9=> inv memory_content(reg) | 1010

### Example:

inv [r1]

binary: 0000 0001 1001 1010

hex: 01 9a

## inv [xx]

Inverts the memory_content(xx).

from | to | what | group
xxxxx | xxxx | 1010 10=> inv memory_content(xx) | 1010

### Example:

inv [2]

binary: 0000 0000 1010 1010, 0000 0000 0000 0010

hex: 00 aa, 00 02

## inv [reg + xx]

Inverts the memory_content(reg + xx).

from | to | what | group
xxxx | bbbb 0-7: r0-r7 8: sp 9: h | 1011 11=> inv memory_content(reg + xx) | 1010

### Example:

inv [r1 + 5]

binary: 0000 0001 1011 1010, 0000 0000 0000 0101

hex: 01 ba, 00 05

## inv.b [reg]

Negates the byte_memory_content(reg).

from | to | what | group
xxxx | bbbb 0-7: r0-r7 8: sp 9: h | 1001 12=> inv byte_memory_content(reg) | 1010

### Example:

inv.b [r1]

binary: 0000 0001 1100 1010

hex: 01 ca

## inv.b [xx]

Inverts the byte_memory_content(xx).

from | to | what | group
xxxxx | xxxx | 1101 13=> inv byte_memory_content(xx) | 1010

### Example:

inv.b [2]

binary: 0000 0000 1101 1010, 0000 0000 0000 0010

hex: 00 da, 00 02

## inv.b [reg + xx]

Inverts the byte_memory_content(reg + xx).

from | to | what | group
xxxx | bbbb 0-7: r0-r7 8: sp 9: h | 1110 14=> inv byte_memory_content(reg + xx) | 1010

### Example:

inv.b [r1 + 5]

binary: 0000 0001 1110 1010, 0000 0000 0000 0101

hex: 01 ea, 00 05
