milanvidakovic/FPGAComputer/(commit log)

2018-08-25 Added swap and additional jump instructions.
    [cpu.v]
2018-09-07 Added PS/2 keyboard support and milliseconds counter register.
